MankiratBhatia/CCIS-Embedded/hardware/wiring_diagram.png

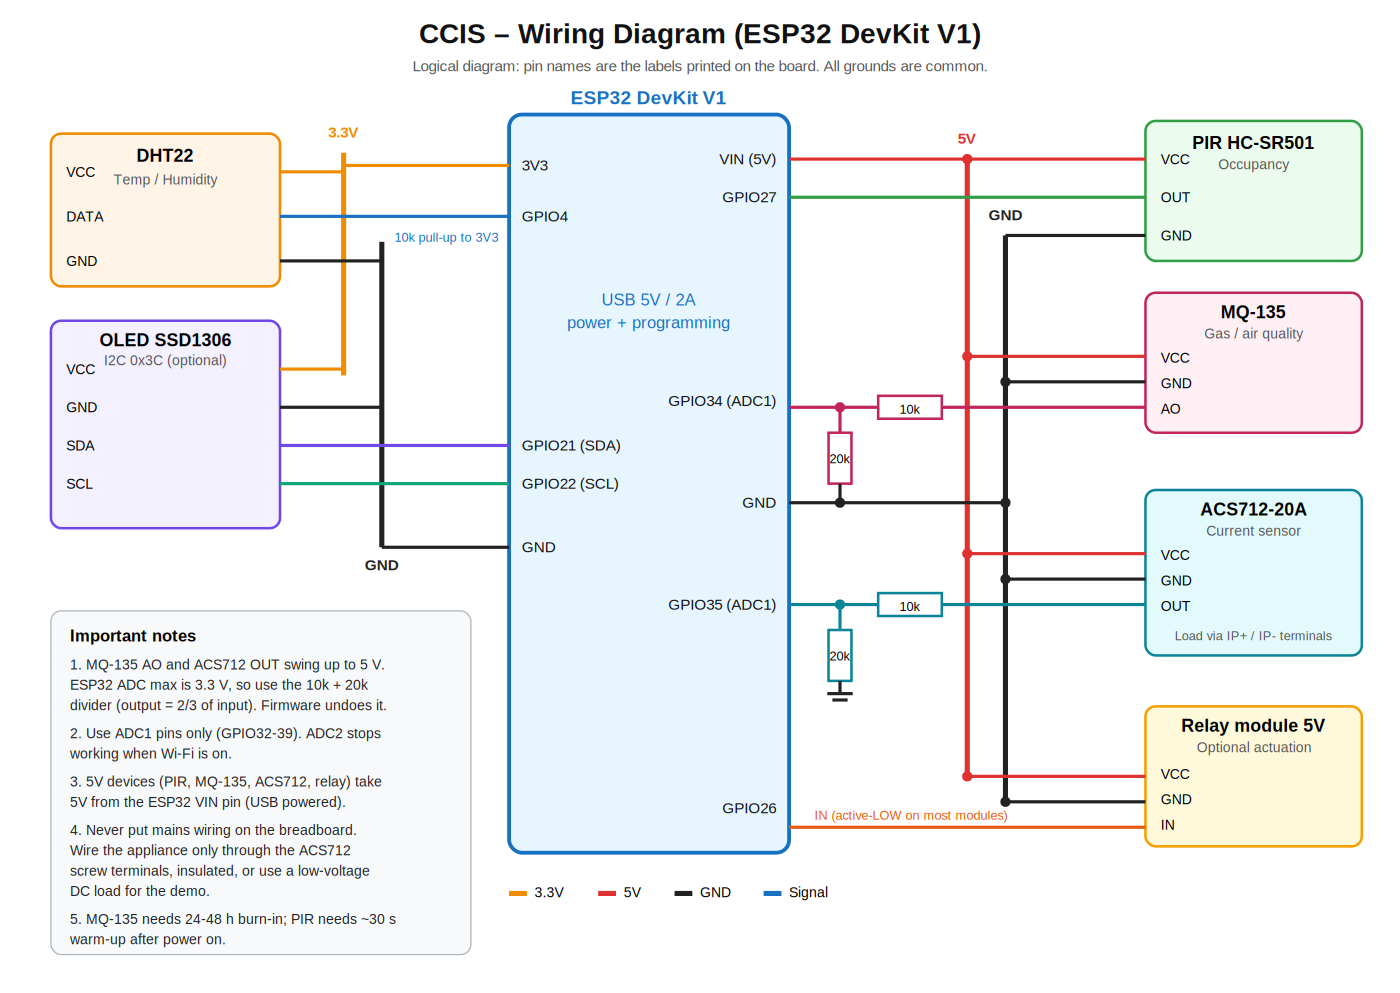
hardware/wiring_diagram.png
