MankiratBhatia/CCIS-Embedded/firmware/ccis_firmware/secrets.example.h

// Copy this file to secrets.h and fill in your own values.
// secrets.h is listed in .gitignore and must never be committed.
const char* WIFI_SSID = "YOUR_WIFI_NAME";
const char* WIFI_PASS = "YOUR_WIFI_PASSWORD";
// Firebase Realtime Database URL (no trailing slash)
const char* DB_URL    = "https://YOUR-PROJECT-default-rtdb.firebaseio.com";
const char* DEVICE_ID = "ccis01";
