MankiratBhatia/CCIS-Embedded/(commit log)

2026-10-18 Add ESP32 firmware and project review document
2026-10-18 Add wiring diagram
